ericgarant/turkey-caller/firmware/README.md

# Firmware

PlatformIO project for two boards (F12):

| Env | Board | Notes |
|---|---|---|
| `wrover` (default) | Freenove ESP32-WROVER-E: 4 MB flash, 8 MB PSRAM (4 MB mapped), microSD slot | The main caller |
| `wroom` | Freenove ESP32-WROOM-32E: 4 MB flash, no PSRAM, no card | The spare. Its known-good build is branch `wroom-final`; `pio run -e wroom -t upload` builds this branch for it |

The ESP32 runs its own Wi-Fi network, serves the control page from `web/`, and plays turkey calls (IMA ADPCM WAV) on a Bluetooth A2DP speaker. Built-in calls are in LittleFS (flash); recordings are on the SD card in `/sounds/`. Phase 0 proved Wi-Fi and Bluetooth audio work together; the next-phase features are specified in `docs/features/`.

| File | Job |
|---|---|
| `src/main.cpp` | Boot order, serial health log every 5 s |
| `src/wav.*` | WAV header reader (format checks, data offset, length in ms) |
| `src/library.*` | Sound list: built-ins (order, names and groups from `data/sounds/index.json`), then the card's recordings (group `mine`); lengths from the WAV headers |
| `src/sdcard.*` | The microSD card (WROVER-E only): mount at boot, free space, "card gone" after a failed read |
| `src/player.*` | WAV/IMA ADPCM decode task, repeat, resampler to 44.1 kHz, 16 KB ring buffer, volume, A2DP data callback |
| `src/bt.*` | A2DP source: finds the saved speaker by name, remembers its address, reconnects |
| `src/web.*` | softAP `TurkeyCaller`, captive DNS, the control page, JSON API, status WebSocket `/ws`. Starts no Wi-Fi in phone-free mode |
| `src/control.*` | The actions the page and the box share: play, stop, volume, the Repeat switch (F15) |
| `src/ui.*` | The box: LCD1602 and four buttons, the call list and playing screens, phone-free switch (F15, WROVER only) |
| `src/settings.*` | Wi-Fi name, password, device name and phone-free mode, in NVS |
| `scripts/prebuild.py` | Before each build: runs `../web/build.py` (page → `src/web_page.h`, fails over 20 KB) and writes `src/version.h` from `git describe` |
| `scripts/check_size.py` | Fails the build if the app binary is over 2.25 MB (90% of the app partition) |
| `tools/sd-probe/` | One-off probe for a new board: chip revision, flash and PSRAM size, whether the card answers and mounts |
| `tools/ui-probe/` | One-off probe for the screen and buttons: LCD address, each press and hold, backlight |
| `partitions.csv` | 2.5 MB app, 1.375 MB LittleFS (`data/`, partition labeled `spiffs` so defaults work), 64 KB coredump. No OTA |

## Flash it (Mac)

The board is plugged into the Mac by USB.

1. Install PlatformIO once: `brew install platformio` (or the PlatformIO extension in VS Code).
2. Get the sounds (needs `brew install ffmpeg`), from the repo root. For the Dindon pack, first copy the five Dindon MP3s into `tools/audio/local/` (see `tools/audio/SOURCES.md`):
   ```sh
   cd tools/audio && ./fetch_turkey_audio.sh
   rm -f ../../firmware/data/sounds/*.mp3 ../../firmware/data/sounds/*.wav   # drop old clips (kee_kee_run is no longer built in)
   cp data/*.wav ../../firmware/data/sounds/   # next to the committed index.json
   cd ../../firmware
   ```
3. Build and flash the firmware, then the sounds:
   ```sh
   pio run -t upload
   pio run -t uploadfs
   ```
   The first build downloads the toolchain and ESP-IDF, then recompiles the ESP-IDF libraries with the trimmed Bluetooth/Wi-Fi settings in `custom_sdkconfig`. That takes 10 minutes or more, once. The build prints `App binary: … of the 2.25 MB budget`.
4. Watch the serial log: `pio device monitor` (Ctrl+C to quit). Every 5 s it prints Bluetooth state, plays, underruns and free heap.

Uploads run at 460800 baud because 921600 fails on this board's CH340 chip under macOS. If upload can't find the board, list ports with `pio device list` and pass one, for example `pio run -t upload --upload-port /dev/cu.usbserial-110`. The Freenove board uses a CH340 USB chip; recent macOS has the driver built in. If it says "Failed to connect", hold the BOOT button while the upload starts.

## The WROVER-E board and its SD card

Probed on Eric's board on 25 Oct 2026 with `tools/sd-probe` (`pio run -d tools/sd-probe -t upload -t monitor`):

- Chip ESP32-D0WD-V3, revision 3.1. Flash 4 MB (`esptool flash-id`), so the partition table and the 2.25 MB budget are unchanged. PSRAM: 4 MB mapped into the heap (the ESP32 maps at most 4 MB; the rest of the 8 MB chip would need himem).
- **SD card: SD_MMC 1-bit mode, CLK GPIO 14, CMD GPIO 15, D0 GPIO 2.** GPIO 4 and 12 are not used (12 is a boot strapping pin). FAT16 or FAT32. Eric's card (960 MB, "APPSD") came with no FAT on it; the probe formatted it (build it with `PLATFORMIO_BUILD_FLAGS="-DPROBE_FORMAT=true"`, which formats only a card that does not mount): FAT32, MBR, 945 MB free. On a Mac: Disk Utility, MS-DOS (FAT), Master Boot Record.
- GPIO 13 is the slot's DAT3 line. 1-bit mode never drives it, and nothing else should be wired to it.
- GPIO 16 and 17 belong to the PSRAM.
- The screen and buttons (F15) use GPIO 21, 22, 25, 26, 32 and 33: see the next section.
- GPIO 2 and 15 are strapping pins. If flashing fails with "Failed to connect" while a card is in, take the card out, flash, and put it back.
- No card or an unreadable card: the board boots and plays the built-ins; serial says `SD card: none`. Inserting a card needs a restart.
- Power for the board tests: the Mac's USB port.

## The box: screen and buttons (F15)

All parts are from the Freenove kit. Probed on 31 Oct 2026 with `tools/ui-probe` (`pio run -d tools/ui-probe -t upload -t monitor`) and board-tested (B21, B22).

| Part | Pin | Wire to |
|---|---|---|
| LCD1602 with I2C backpack (GJD 1602IIC, address **0x3F**) | SDA | GPIO 21 |
| | SCL | GPIO 22 |
| | VCC | the **5V** rail, not 3.3 V |
| | GND | GND |
| Yellow button (Up) | one leg / the other | GPIO 32 / GND |
| Blue button (Down) | | GPIO 33 / GND |
| Green button (Play) | | GPIO 25 / GND |
| Red button (Stop) | | GPIO 26 / GND |

- **Screen power:** on 3.3 V the screen lights blue but shows no text. Eric's module has no contrast screw; its contrast is fixed for 5 V.
- **Button legs:** each button has 4 legs. The two legs facing each other across the breadboard's middle groove are always connected. Put the GPIO wire and the GND wire on the **same side** of the groove (top leg and bottom leg). Wired across the groove, the button reads pressed all the time, and serial says `the ... button reads pressed at boot` (a button held at boot logs the same, harmlessly).
- No resistors: the firmware turns on the internal pull-ups.
- With no screen connected, serial says `LCD: none` and the caller works as before.
- A full rewrite of the LCD takes about 60 ms at 100 kHz, so the firmware only writes characters that changed, and reads the buttons on their own 5 ms timer.

| Button | On the call list | While a call plays |
|---|---|---|
| **Yellow** | Previous call | Volume up |
| **Blue** | Next call | Volume down |
| **Green** | Play the call shown | Hold 1 s: Repeat on or off |
| **Red** | Next animal (Turkey, Moose, Deer). Hold 3 s: Wi-Fi off or on (phone-free mode) | Stop |
| **BOOT** (on the board) | Hold 5 s: with Wi-Fi off, turns it back on (name and password kept). With Wi-Fi on, resets the Wi-Fi name, password and device name to the factory values | Same |

The screen's backlight turns off after 30 s without a press. The first press of any button only wakes it.

**Phone-free mode:** hold red 3 s on the call list. The box shows "Wi-Fi off / Restarting...", restarts with no Wi-Fi network, and the boot screen says "Wi-Fi off". Internal heap goes from about 77 KB to 135 KB. The choice survives power cycles. Hold red 3 s again, or BOOT 5 s, to turn Wi-Fi back on.

## Connect the speaker and test

1. Turn the speaker on and put it in pairing mode (Samsung Level Box Slim: hold the Bluetooth button until it announces pairing).
2. On a phone, join Wi-Fi **TurkeyCaller**, password **gobble123** (the factory settings; change them under **Settings**). The page should pop up; if not, open `http://192.168.4.1`.
3. Under **Speaker**, tap **Search for speakers**. The ESP32 lists the speakers it finds; tap **Use** next to yours. The ESP32 saves it and connects by address (no restart), and from then on reconnects to that speaker by itself: every 3 s for the first minute it is gone, then every 10 s. A tap on a speaker that went to sleep wakes it first (the page says "Waking the speaker"); if it doesn't answer within 8 s the page says so.
4. Tap the call buttons. **Repeat** loops a call, **Stop** and the **volume** slider act right away (volume is saved).
5. From a computer on the board's Wi-Fi, `cd web && node test/stress.mjs http://192.168.4.1` taps 50 calls and reports failed taps, underruns and the lowest free heap, and `node test/api.mjs http://192.168.4.1` checks the API contract.

The page is part of the app binary, so `pio run -t upload` updates it and keeps the sounds. `uploadfs` rewrites the whole LittleFS partition (sounds and `index.json`). To change speakers (for example the Cooboom later), tap **Forget** and pick the new one.

## Sounds

Clips are `data/sounds/<id>.wav`, where the id is `a-z0-9_`, 24 characters at most. `data/sounds/index.json` (hand-written, in git) gives each id its place, display name and group (`soft`, `loud`, `care`, `pack`). `pack` is the Dindon pack: five calls cut from Eric's own MP3s (the built-in kee-kee run was dropped to make room) (purr & clucks, yelp, fast yelp, kee-kee run, gobble). Where each clip comes from and when to use each call is in `tools/audio/SOURCES.md`. Files that are not in the index are listed after the others with a name made from the id. A sound in the index without a file is not listed, and a broken file is skipped with a `sound … skipped: <why>` line on serial.

## API

The contract is in `../web/README.md`. POST bodies are form fields; replies are JSON. `/api/status` (and each `/ws` push) includes `version`, `minHeap` (internal heap), `fsFree` and `fsTotal` (flash), `sdFree` and `sdTotal` (the card, 0 and 0 with none) and `psramFree` (0 on the WROOM board). `error` carries "SD card removed" when a recording stops because the card failed. Not built yet, and answering 501: upload and delete (`POST /api/sounds`, `/api/sounds/delete`, F03).

## Known limits

- Bluetooth searching takes most of the shared radio, enough that phones can fail to join the Wi-Fi. So with no speaker saved, the ESP32 only searches after you tap **Search for speakers**, and it favours Wi-Fi while searching. Each search is one round of about 25 s (10 s setup, then ~13 s of inquiry), and the page can be slow or briefly unreachable during it; found speakers stay listed afterwards. Every device seen is printed on serial as a `saw …` line. With a saved speaker that is switched off, it keeps trying to reconnect, so turn the speaker on first.
- Clips must be mono WAV, IMA ADPCM or 16-bit PCM, at 8 to 44.1 kHz (resampled to the A2DP rate of 44.1 kHz). Anything else is refused with an error on serial.

## Settings (F05)

`src/settings.*` keeps the Wi-Fi name, password and device name in NVS (namespace `cfg`). The page's **Settings** screen changes them through `/api/config`. A device-name change applies at once on every phone (the Bluetooth name follows at the next restart); a Wi-Fi name or password change makes the board send `{"evt":"restart"}` to every page and restart about 1 s later. The password never leaves the board: not in replies, WebSocket messages or the serial log.

**Forgot the password?** With the board running and Wi-Fi on, hold the **BOOT** button for 5 s. Serial prints `BOOT held 5 s: …`, the Wi-Fi name, password and device name go back to `TurkeyCaller` / `gobble123` / `Turkey Caller`, and the board restarts. The speaker, volume and sounds are kept. Holding BOOT while plugging in or pressing EN starts the chip's download mode instead, which is not this. In phone-free mode, BOOT held 5 s only turns Wi-Fi back on and keeps the name and password (`BOOT held 5 s: Wi-Fi back on`).
