ericgarant/turkey-caller/hardware/case/base.stl

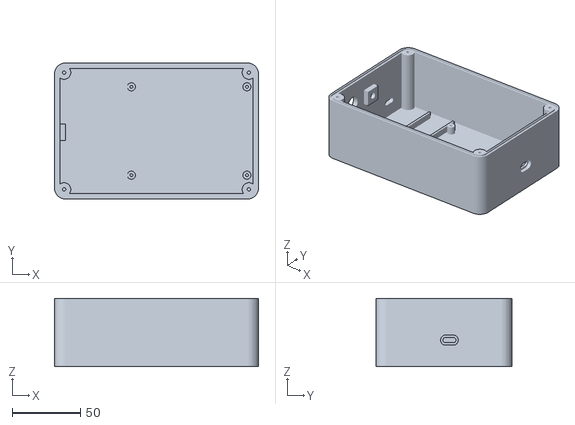
[picture p4: CAD file, 2026-11-01]
hardware/case/base.stl
150.0 x 100.0 x 50.0
