ericgarant/turkey-caller/hardware/case/fit_test.stl

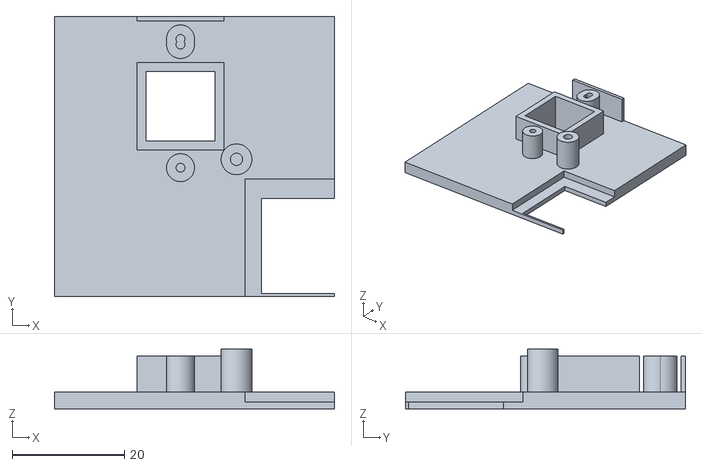
[picture p5: CAD file, 2026-11-01]
hardware/case/fit_test.stl
50.0 x 50.0 x 10.7
