ericgarant/turkey-caller/hardware/case/lid.stl

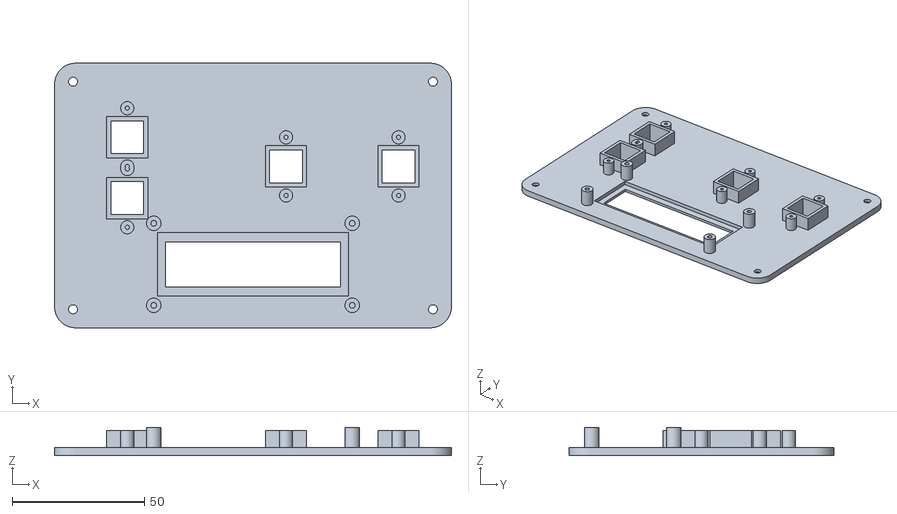
[picture p6: CAD file, 2026-11-01]
hardware/case/lid.stl
150.0 x 100.0 x 10.7
