ericgarant/turkey-caller/hardware/case/clamp.stl

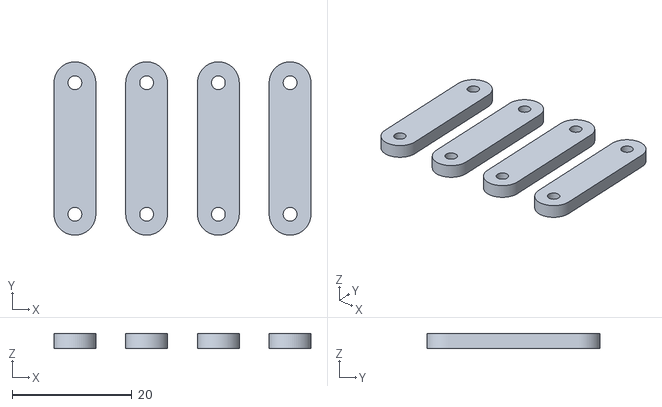
[picture p7: CAD file, 2026-11-01]
hardware/case/clamp.stl
43.0 x 29.0 x 2.50
