ericgarant/turkey-caller/hardware/case/gasket.stl

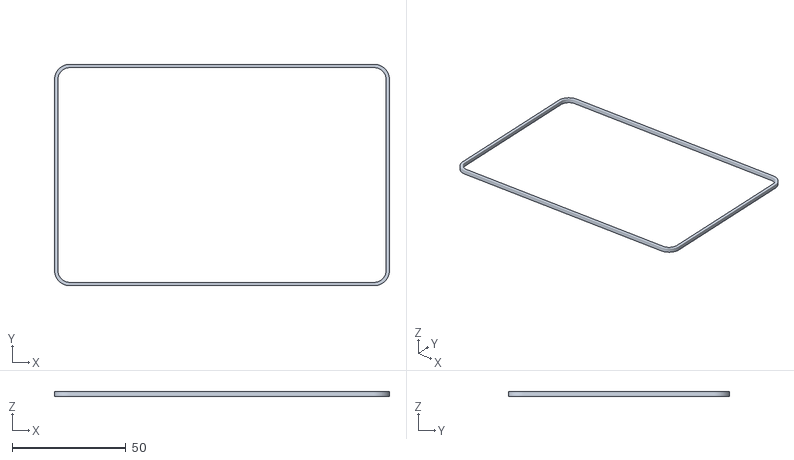
[picture p8: CAD file, 2026-11-01]
hardware/case/gasket.stl
147.5 x 97.5 x 2.20
