ericgarant/turkey-caller/(commit log)

2026-10-23 Add architecture summary, flash layout and project layout (#2)
    * Add architecture summary, flash layout and project layout
    Claude-Session: https://claude.ai/code/session_01K7sxUfxNpeAEHmdAx2Dc8L
    * Address review: licence rule, spiffs label, app size check, upload lock, versioned index.json
    Claude-Session: https://claude.ai/code/session_01K7sxUfxNpeAEHmdAx2Dc8L
    * README: note that sounds/index.json is kept in git
    Claude-Session: https://claude.ai/code/session_01K7sxUfxNpeAEHmdAx2Dc8L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
    [partitions.csv]
2026-10-23 Add turkey call audio fetch and convert script (#1)
    * Add turkey call audio fetch and convert script
    Downloads 11 labeled wild turkey calls and converts them to mono
    64 kbps MP3 for the ESP32. Audio is not committed (all rights reserved).
    Claude-Session: https://claude.ai/code/session_01WQ3sQrz8rnCcKRC2Zrm1Pm
    * Address review: pin working dir, harden summary loop
    - cd to the script's folder so raw/ and data/ always land in git-ignored paths
    - skip a clip whose conversion fails instead of aborting the batch
    - summarize only the current format and say so when no clips exist
    - point the flash budget at firmware/partitions.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
2026-10-24 Add the web control page, mock API server and smoke test (#4)
    * Add the web control page, mock API server and smoke test
    Calls, Speaker and Settings screens in one offline index.html (10 KB
    gzipped), with a dim red dawn mode. web/build.py gzips it into
    firmware/data/www for uploadfs. The mock server and Playwright smoke test
    let the page be built and checked without the board. API contract agreed
    with the firmware thread is in web/README.md.
    Claude-Session: https://claude.ai/code/session_01F2Du3ajcKfs7TPg6SPszug
    * Embed the page in the firmware and address review
    - build.py now writes firmware/src/web_page.h (kWebPageGz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
2026-10-24 Add QA test plan, API contract test and stress script (#5)
    * Add QA test plan, API contract test and stress test script
    Claude-Session: https://claude.ai/code/session_01BNRUcCEU7Wc7W3TDj8q17R
    * QA: stress delta and reboot check, api test against the board, Phase 0 column
    Claude-Session: https://claude.ai/code/session_01BNRUcCEU7Wc7W3TDj8q17R
    * QA: restore volume after the API test, fix comment quoting
    Claude-Session: https://claude.ai/code/session_01BNRUcCEU7Wc7W3TDj8q17R
    ---------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
2026-10-24 Phase 0 firmware: Wi-Fi test page + Bluetooth ADPCM playback (#3)
    * Add Phase 0 firmware: softAP test page + A2DP MP3 playback
    PlatformIO project for the Freenove ESP32-WROOM-32E (pioarduino, Arduino 3.3.0):
    - player: Helix MP3 decode task from LittleFS int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
    [partitions.csv]
2026-10-24 Give Wi-Fi the radio until a phone joins; log joins (#7)
    * Give Wi-Fi the radio until a phone has joined
    With the speaker connected the A2DP stream runs all the time (silence
    too), and under balanced radio sharing a phone failed to join the access
    point ("Connection failed"). Prefer Wi-Fi while no phone is joined,
    since there is nothing to play then, and share the radio once one is.
    Claude-Session: https://claude.ai/code/session_01FfFaMRvVrnK6SGCWJRu4sX
    * Log phones joining and leaving the access point
    Claude-Session: https://claude.ai/code/session_01F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
    [bt.cpp, web.cpp]
2026-10-24 F01 + F02: serve the control page from the firmware; WAV sound library (#9)
    * Serve the control page from the firmware; WAV sound library (F01, F02)
    F01: web/index.html is built into the app by scripts/prebuild.py (runs
    web/build.py, fails the build on error) and served at / gzipped with an
    ETag and Cache-Control: no-cache. The Phase 0 test page is removed. New
    /ws WebSocket pushes status on change, every 2 s while playing, else
    every 10 s, and takes volume and stop commands. Status gains loop,
    pos_ms, len_ms, fsTotal and version (git describe); bt reports only
    idle/searching/connecting/connected. /api/bt/devices returns
    {scanning, devices}. Upload, delete and /api/config answer 501 until
    F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
    [bt.cpp, library.cpp, library.h, main.cpp, player.cpp, player.h]
2026-10-24 F10: lower the page-load heap dip (request cap, sequential load, small TCP send buffer, small clip read buffer) (#10)
    * Lower the page-load heap dip: cap requests in flight, load one thing at a time (F10)
    The lowest heap (37.3 KB on 6ce066b) was set while a phone joined and
    loaded the page. Fixes:
    - At most 4 HTTP requests in flight (the /ws socket aside); more get a
    503 with Retry-After, and the page retries 503s.
    - /favicon.ico answers 204, and the page declares an empty icon. Before,
    the favicon request was redirected to / and fetched the whole page a
    second time during every load.
    - The page loads sounds, then config, one at a time, and takes its
    first status from the socket's p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
    [player.cpp, web.cpp]
2026-10-24 F08 + F04 + F10: smooth saved volume, shared Repeat, two-phone heap fixes, request watchdog (#11)
    * Volume ramps and logs its save; repeat ends on disconnect and is remembered (F08, F04)
    F08: the gain ramps to a new volume over ~6 ms instead of jumping, and
    each NVS save prints "volume N saved" (one write after the slider
    settles). The mock starts at 70 like the firmware.
    F04: a speaker disconnect stops playback, so a repeating call ends and
    nothing plays by itself after the reconnect. The page remembers the
    Repeat switch on the phone, and after a reload during a repeat it shows
    the switch on (from loop in status).
    Claud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
    [bt.cpp, bt.h, heapmon.cpp, heapmon.h, main.cpp, player.cpp, player.h]
2026-10-24 Docs follow-up to deferring uploads; restore etag comment (#13)
    * Docs follow-up to deferring uploads; restore etag comment
    Mark QA row B13 deferred, describe the hidden upload controls
    (EDIT_SOUNDS), drop upload from F06 and the web README's current
    features, point F01's size budget at the architecture doc.
    * qa-test-plan: smoke test checks upload/delete are hidden
    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
2026-10-25 Add automated feature tests on the mock board (#15)
    * QA: feature tests on the mock (volume, shared Repeat, busy recovery, speaker wake), two-phone browser test, parked upload tests
    Fix the mock's WebSocket accept GUID so standard clients can connect.
    * features.mjs: refuse to run against the real board without DESTRUCTIVE=1
    It forgets and re-pairs the speaker with a fake address.
    * QA: guard feature tests against a rea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
2026-10-25 F06 + F07: speaker use/forget without restart, auto-reconnect backoff, wake on tap (#14)
    * Speaker reconnect and idle wake: one state machine for F06 and F07
    F06: Use connects by address and Forget disconnects and clears, both without a
    restart, run on the A2DP library's own task. A down speaker is retried every 3 s
    for the first minute, then every 10 s; a search that finds nothing goes back to
    reconnecting. A nameless speaker is usable by address. The busy window starts
    when the speaker actually connects, so attempts to a speaker that is off never
    hold off the page.
    F07: status has `stream` (ready, waking, suspended, down) and `error`. A tap
    when the stream isn't ready answers 202 {"wakin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
    [bt.cpp, bt.h, player.cpp, player.h, web.cpp]
2026-10-25 Add the Dindon pack: 5 new calls in their own section with when-to-use notes (#16)
    Purr & clucks, yelp, fast yelp, kee-kee run and gobble, cut from Eric's
    Dindon MP3s (read from tools/audio/local, never committed) to ~221 KB of
    ADPCM. New group 'pack' shown as 'Dindon pack'. Sources and usage notes
    in tools/audio/SOURCES.md.
    Claude-Session: https://claude.ai/code/session_014tjzWb56NGhHUw43VtZJGr
2026-10-25 Settings screen that stays in step on both phones (F05, web side) (#17)
    * Settings screen that stays in step on both phones (F05 web side)
    - Wi-Fi name, password and device name, with inline checks, a Show
    button, a factory-password reminder and the device name in the header
    - Live sync: status carries cfg (the settings rev); each page reloads
    /api/config on a change, keeps fields being edited and flags them;
    stale saves get 409 and are reloaded instead of applied
    - Name-only changes save without a restart; Wi-Fi changes show the
    rejoin message on both phones via a WS restart event, also for the
    BOOT reset
    - Mock: rev, default_pass, restart simulation, BOOT reset hook; fix the
    W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
2026-10-25 F05 firmware: Wi-Fi name, password and device name settings (#19)
    * F05 firmware: Wi-Fi name, password and device name settings
    Settings live in NVS (namespace cfg). GET/POST /api/config with the rev
    conflict check, cfg in status and in the pushed state, a restart notice
    over the WebSocket before a Wi-Fi change restarts the board, and a 5 s
    BOOT-button hold that resets the three settings to the defaults. The
    device name is the Bluetooth name from the next boot. The password is
    never sent or logged.
    Claude-Session: https://claude.ai/code/session_01GGYpV9R1KHuEBEonUwF4xB
    * Settings: no NVS NOT_FOUND errors on serial before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
    [bt.cpp, main.cpp, settings.cpp, settings.h, web.cpp]
2026-10-25 Settings: drop the extra config reload after a save; count name limits in bytes (#20)
    * Settings: no extra config GET after a save; name limits in bytes
    The saving phone no longer re-GETs /api/config after its own POST; the
    board's cfg push already reloads every phone, and the second GET dipped
    the heap to 36-40 KB with two phones (issue #8). Name and password limits
    are checked in UTF-8 bytes like the firmware, with a hint that accented
    letters count as 2. Mock and tests follow.
    * Settings: password must be printable ASCII; saver takes rev+1 after i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
2026-10-25 Add instructions page to the web app (#21)
    * Instructions page: join, pair, play, settings, 5 s BOOT reset, troubleshooting (+1.1 KB gzipped)
    Claude-Session: https://claude.ai/code/session_01U7TvEMyy182ceqCGHSV146
    * Instructions: search takes up to 25 s, Use switches directly, plain-ASCII password, search-running line
    Claude-Session: https://claude.ai/code/session_01U7TvEMyy182ceqCGHSV146
    ---------
2026-10-25 Docs: move to the WROVER-E with SD card (F12); resume phone upload on top of it (#22)
    * Docs: F12 spec for the WROVER-E with SD card; resume F03 on top of it, F09 superseded
    * F12: wroom-final is a branch
    * F12: review fixes (internal audio buffers, bounded card failure, rev 3 PSRAM, strapping pins, power)
    Claude-Session: https://claude.ai/co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
2026-10-25 Docs: F13 motion sensor (HC-SR501) and LED (#23)
    * Docs: F13 motion sensor (HC-SR501) and LED spec
    * F13: review fixes (PIR on GPIO 34/35, 5 V and jumper setup, LED resistor, led_motion in the F05 contract, warm-up on power-on only)
    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
2026-10-25 F13: PIR stays on GPIO 13 (soldered); SD mount retry at boot if DAT3 clashes (#24)
    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
2026-10-25 F12 firmware: WROVER-E with PSRAM and SD card recordings (#26)
    * F12: wrover env with PSRAM, SD card recordings, sdFree/sdTotal/psramFree in status
    * F12: SD probe results in the firmware README; probe reads the card raw and leaves GPIO 13 alone
    * F12 probe: optional format of a card with no file system; README records the formatted card
    * F12: keep the PSRAM cache workaround; REV_MIN_3 panics at boot
    * F12 revie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
    [library.cpp, library.h, main.cpp, player.cpp, player.h, sdcard.cpp, sdcard.h]
2026-10-25 F14 firmware: call packs on the SD card (turkey, moose, deer) (#28)
    * F14 firmware: call packs on the SD card with animal and hint, one id namespace, sound list in PSRAM
    * F14: build moose (13) and deer (9) packs from all three of Eric's folders; DeerCalls are deer
    * F14 packs: DeerCalls ids, names and hints match PR #29
    * F14: no error line when the card has no /packs folder
    * F14 packs: TurkeyCalls as a full-le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
    [library.cpp, library.h, player.cpp, web.cpp]
2026-10-25 Docs: drop F13 (PIR and LED removed from the board) (#32)
    Eric took the motion sensor and LED off the board to keep the caller
    simple and reliable. F13 is marked dropped, the build order and pin
    notes no longer mention them, and the SD probe stops reading GPIO 13.
    Also notes that F03 has landed.
    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
    [main.cpp]
2026-10-31 Architecture: write down the rules every change follows (#34)
    Collects the rules enforced so far (board, memory, sounds, API,
    process) in one place, and brings the modules, storage and upload
    rows up to date with F03, F12 and F14.
    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
2026-10-31 F15 spec and breadboard probe: screen and buttons on the box (#35)
    * F15 spec and breadboard probe: LCD1602 and four big buttons on the box
    Eric picked option A (kit parts only) on 31 Oct 2026. Adds the F15 spec,
    a probe that finds the LCD's I2C address and shows each button press,
    a CI build of the probe, and the planned pins and ui module in the docs.
    * F15: record the probe results (LCD at 0x3F, button wiring, 59 ms rewrite)
    -------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
2026-10-31 F15 firmware: pick and play calls from the box's screen and buttons (#36)
    * F15 firmware: pick and play calls from the box's screen and buttons
    New ui module (TC_HAS_UI, WROVER only): LCD1602 at 0x27 or 0x3F, four
    buttons sampled by a 5 ms timer, Picking and Playing screens, volume,
    Repeat, backlight timeout, and it follows calls started from a phone.
    New control module holds the shared play, stop, volume and Repeat
    actions so the page and the box drive the same state.
    * ui: rename select() to choose() (lwIP can define select as a macro)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
2026-10-31 F15: phone-free mode, and the box's buttons in all docs (#37)
    * F15 phone-free mode: hold red 3 s on the box to turn Wi-Fi off or on
    Saved in NVS (cfg/wifioff), applied at a restart. With Wi-Fi off, web::begin
    starts no access point or server and web::loop only watches the BOOT button,
    whose 5 s reset turns Wi-Fi back on. Red on the call list now acts on release
    (short: next animal, 3 s: Wi-Fi); during a call it still stops on the press.
    Spec gains QA row B22; the page's Instructions explain the mode.
    * main: no Wi-Fi join hint at boot in phone-free mode
    Co-Auth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
    [main.cpp, settings.cpp, settings.h, ui.cpp, web.cpp, web.h]
2026-10-31 Fix: the first play after the 5 min idle pause gets dropped (#38)
    Co-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
    [bt.cpp]
2026-11-01 Add a printable case model for the caller
    Parametric OpenSCAD model (base, lid, TPU gasket, button clamps, fit test)
    sized for the Freenove kit's 12 mm square-cap buttons, the GJD 1602IIC LCD
    and the WROVER board on a perfboard, with STL files and a print guide.
    Claude-Session: https://claude.ai/code/session_01GDwniz1mifnG6j19dxcvss
    [base.stl, clamp.stl, fit_test.stl, gasket.stl, lid.stl, turkey-caller-case.scad]
